LaboratoryOfPlasmaPhysics/ComAir-eval/(commit log)

2021-12-07 init, first layout almost complete
    [ComAir-eval.kicad_pcb, ComAir-eval.sch, Power.sch, Sensor.sch, USB.sch]
2021-12-10 PCB ready for review
    [ComAir-eval.kicad_pcb, ComAir-eval.sch, Power.sch, Sensor.sch]
2021-12-24 Adds SWD debug probe
    [ComAir-eval.kicad_pcb, ComAir-eval.sch]
2022-01-31 Fix stupid zones overlap mistake (3.3V and GND :/) and switch to kicad 6
    [ComAir-eval.kicad_pcb, ComAir-eval.kicad_sch, ComAir-eval.sch, Power.kicad_sch, Power.sch, Sensor.kicad_sch, Sensor.sch, USB.kicad_sch]
2022-01-31 Set release number to 1.1
    [ComAir-eval.kicad_pcb, ComAir-eval.kicad_sch, Power.kicad_sch, Sensor.kicad_sch, USB.kicad_sch]
